arhefner/1802-Mini-I2C/README.md

# 1802-Mini-I2C
I2C interface board for the 1802-Mini-PIO
