arhefner/1802-Mini-I2C/notes/1802-Mini-I2C-BOM.xlsx

Please refer to these notes as applicable for the parts list below:
*A | These connectors may be pre-installed on the board.
PARALLEL INTERFACE
Qty | Description |  | Manufacturer | Manufacturer # | Vendor | Vendor # | Price | Qty | Total
Integrated Circuits
1 | LM3940IT-3.3 Regulator | U1 | TI | LM3940IT-3.3/NOPB | Digikey | LM3940IT-3.3/NOPB-ND | 2.00 | 1.00 | 2.00
Discrete Components
2 | Transistor 2N3904 | Q1,Q4 | ON Semi | 2N3904BU | Digikey | 2N3904FS-ND | 0.38 | 2.00 | 0.76
2 | N Channel FET TN0702 | Q2,Q3 | Microchip | TN0702N3-G | Digikey | TN0702N3-G-ND | 1.44 | 2.00 | 2.88
1 | Ceramic capacitor 0.47uF radial 2.50mm | C1 | TDK | FG14X7R1E474KNT06 | Digikey | 445-180818-1-ND | 0.35 | 1.00 | 0.35
1 | Aluminum capacitor 47uF radial 2.50mm | C2 | Kemet | ESY476M050AE3AA | Digikey | 399-ESY476M050AE3AA-ND | 0.33 | 1.00 | 0.33
2 | Resistor 1/4 watt 1K | R1,R5 | Stackpole | CF14JT1K00 | Digikey | CF14JT1K00CT-ND | 0.10 | 2.00 | 0.20
6 | Resistor 1/4 watt 10K | R2-R4,R6-R8 | Stackpole | CF14JT10K0 | Digikey | CF14JT10K0CT-ND | 0.10 | 6.00 | 0.60
Interconnects
1 | Straight header 3 pins 0.1" | JP1 | Sullins | PREC003SAAN-RC | Digikey | S1012EC-03-ND | 0.09 | 1.00 | 0.09
2 | Straight header 2 pins 0.1" | JP2,JP3 | Sullins | PREC002SAAN-RC | Digikey | S1012EC-02-ND | 0.06 | 2.00 | 0.12
2 | Straight dual row header 8 position | J1,J3 | Sullins | PREC008DAAN-RC | Digikey | S2012EC-08-ND | 0.35 | 2.00 | 0.70
3 | Jumper shunts 0.1" |  | Sullins | STC02SYAN | Digikey | S9000-ND | 0.09 | 3.00 | 0.27
2 | R/A header 4 pin 0.1" | J5,J6 | Sullins | PREC004SBAN-M71RC | Digikey | S1112EC-04-ND | 0.15 | 2.00 | 0.30
2 | R/A 4 pin 1mm pitch connector (Qwiic)(*A) | J2,J4 | JST | SM04B-SRSS-TB(LF)(SN) | Digikey | 455-1804-1-ND | 0.59 | 2.00 | 1.18
Mechanical
1 | Circuit Board |  | Hefner |  | JLCPCB |  | 5.00 | 1.00 | 5.00
 |  |  |  |  |  |  | Total |  | 14.78
