arhefner/1802-Mini-I2C/SM04B-SRSS-TB_LF__SN_.step

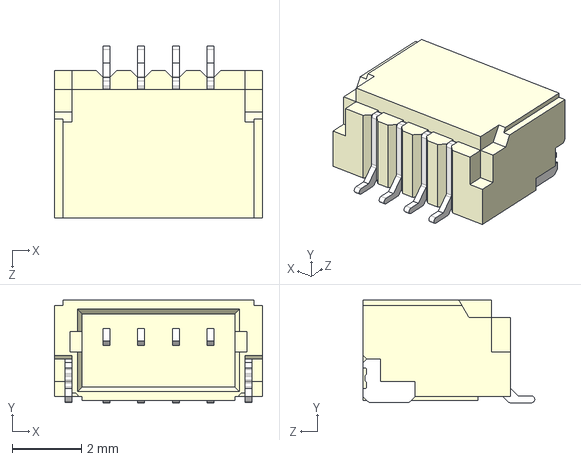
[picture p1: CAD file, 2023-01-06]
SM04B-SRSS-TB_LF__SN_.step
6.00 x 2.96 x 4.95 mm
