arhefner/1802-Mini-I2C/notes/1802-Mini-I2C.pdf

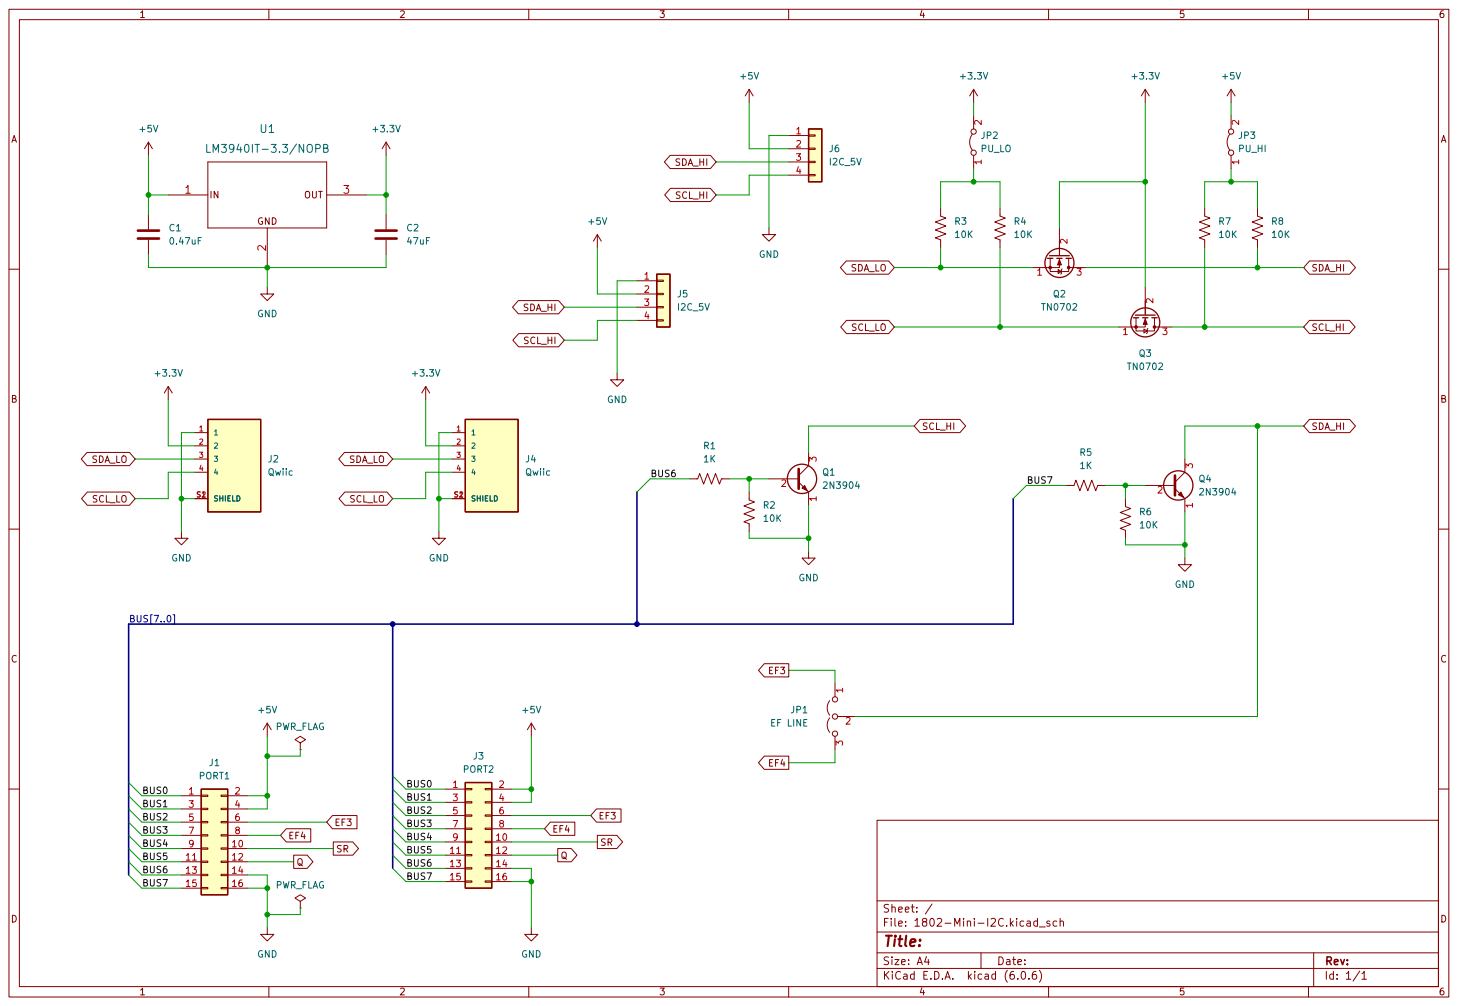
[picture p2: page 1]
