arhefner/1802-Mini-I2C/1802-Mini-I2C.kicad_pcb

## KiCad design 1802-Mini-I2C.kicad_pcb (2023-01-14)

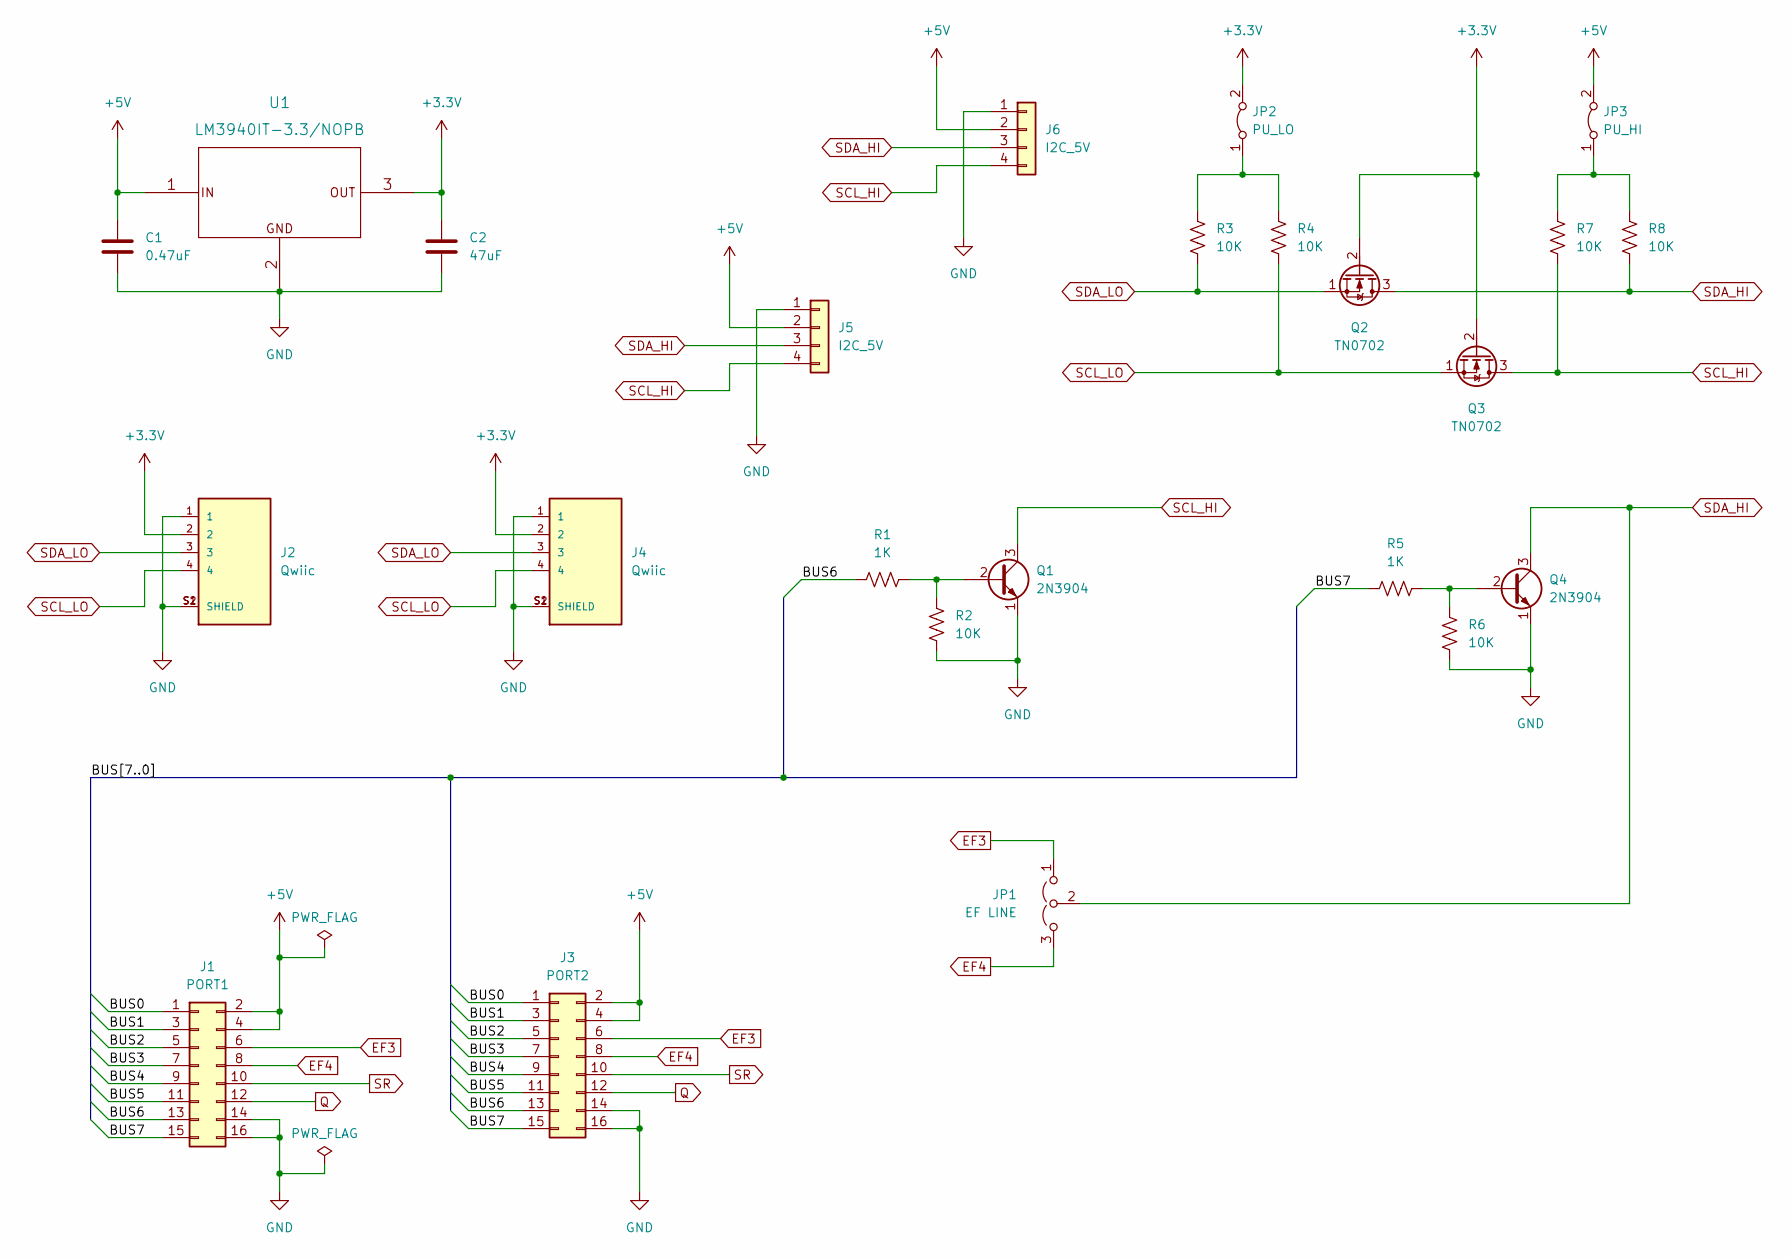
[picture p3: schematic 1802-Mini-I2C.kicad_sch]

Parts:
C1: 0.47uF; C_Disc_D5.0mm_W2.5mm_P2.50mm
C2: 47uF; C_Radial_D6.3mm_H11.0mm_P2.50mm
J1: PORT1; PinHeader_2x08_P2.54mm_Vertical
J2, J4: Qwiic; JST_SM04B-SRSS-TB(LF)(SN)
J3: PORT2; PinHeader_2x08_P2.54mm_Vertical
J5, J6: I2C_5V; PinHeader_1x04_P2.54mm_Vertical
JP1: EF LINE; PinHeader_1x03_P2.54mm_Vertical
JP2: PU_LO; PinHeader_1x02_P2.54mm_Vertical
JP3: PU_HI; PinHeader_1x02_P2.54mm_Vertical
Q1, Q4: 2N3904; TO-92
Q2, Q3: TN0702; TO-92
R1, R5: 1K; R_Axial_DIN0207_L6.3mm_D2.5mm_P10.16mm_Horizontal
R2, R3, R4, R6, R7, R8: 10K; R_Axial_DIN0207_L6.3mm_D2.5mm_P10.16mm_Horizontal
U1: LM3940IT-3.3/NOPB; TO-220-3_Horizontal_TabDown

Connections:
+3.3V: C2.1, J2.2, J4.2, JP2.2 (B), Q2.2 (G), Q3.2 (G), U1.3 (OUT)
+5V: C1.1, J1.2, J1.4, J3.2, J3.4, J5.2, J6.2, JP3.2 (B), U1.1 (IN)
/BUS0: J1.1, J3.1
/BUS1: J1.3, J3.3
/BUS2: J1.5, J3.5
/BUS3: J1.7, J3.7
/BUS4: J1.9, J3.9
/BUS5: J1.11, J3.11
/BUS6: J1.13, J3.13, R1.1
/BUS7: J1.15, J3.15, R5.1
EF3: J1.6, J3.6, JP1.1 (A)
EF4: J1.8, J3.8, JP1.3 (B)
GND: C1.2, C2.2, J1.14, J1.16, J2.1, J2.S1 (SHIELD), J2.S2 (SHIELD), J3.14, J3.16, J4.1, J4.S1 (SHIELD), J4.S2 (SHIELD), J5.1, J6.1, Q1.1 (E), Q4.1 (E), R2.1, R6.1, U1.2 (GND)
unnamed: JP2.1 (A), R3.2, R4.2
unnamed: JP3.1 (A), R7.2, R8.2
unnamed: Q1.2 (B), R1.2, R2.2
unnamed: Q4.2 (B), R5.2, R6.2
Q: J1.12, J3.12
SCL_HI: J5.4, J6.4, Q1.3 (C), Q3.3 (D), R7.1
SCL_LO: J2.4, J4.4, Q3.1 (S), R4.1
SDA_HI: J5.3, J6.3, JP1.2 (C), Q2.3 (D), Q4.3 (C), R8.1
SDA_LO: J2.3, J4.3, Q2.1 (S), R3.1
SR: J1.10, J3.10

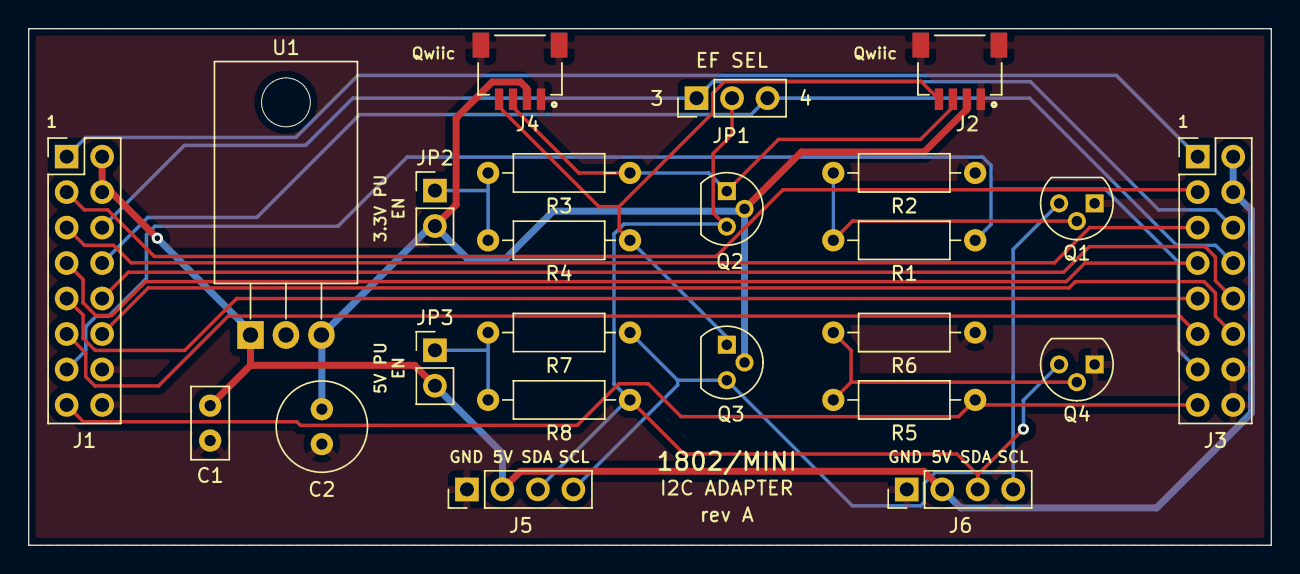
[picture p4: board 1802-Mini-I2C.kicad_pcb from above]

Board: 2 copper layers, 89.0 x 37.0 mm, 24 parts (0 on the bottom side), 23 nets.
